MatthewMa11/WebbSubmarineROV/docs/superpowers/specs/2026-10-26-club-website.md

# Webb Submarine ROV Club Website

Date: October 26, 2026

The user authorized a public club website and a public GitHub repository. The site introduces the club, shows actual engineering work, explains its museum vision, and makes journals and CAD downloads easy to find. The root agent owns GitHub publication and browser verification.

## Approach

Use a buildless static page at the repository root for GitHub Pages. A framework would add unnecessary build and dependency maintenance to this editorial site. Sites hosting is not used because the requested host is GitHub Pages. The existing project checkout and source image paths are retained.

## Content and design

Use deep navy, warm cream, and cyan with large system typography, ruled editorial sections, and prominent authentic CAD imagery. The opening combines the club's underwater engineering purpose with the current thruster model. Subsequent sections explain current development, link both journals, introduce prospective museum education and documentation, and provide the print kit and archive.

The current configuration is R14 housing + R13 concave cone + R11 fan. Distinguish CAD/fabrication development from demonstrated underwater operation. Keep the museum unnamed and activities aspirational. Do not invent membership, achievements, partnerships, contact details, or performance specifications.

## Files and constraints

- `index.html`: semantic content and native link navigation.
- `site-assets/site.css`: all styles, responsive layouts and accessibility states.
- `.nojekyll`: serve the static source directly on GitHub Pages.
- No external dependencies, fonts, analytics, frameworks, or required JavaScript.
- Use existing CAD images through relative paths; no copied or generated assets.
- GitHub links target `MatthewMa11/WebbSubmarineROV` and the established CAD release.

## Verification

Check local asset existence, fragment targets, heading hierarchy, accessible image text, metadata, and relative image/style URLs. The parent agent verifies the actual desktop and narrow-screen rendering, keyboard focus, links, publication and HTTP response. Do not claim deployment from local checks.
