MatthewMa11/WebbSubmarineROV/cad/concave-cap-r13-2026-10-25/native-saved-version.txt

Browser tab: 5, Title: "A2212 R8 - M3 axle-clamp fan - separate design | R13 thruster - concave cone and M3x12 joints", URL: "https://cad.onshape.com/documents/743ab214882a2e3f8cf7645e/v/b026d3e43969875b68fe1d72/e/7d8ed648695214607ccb8d84".
0 AXWebArea A2212 R8 - M3 axle-clamp fan - separate design | R13 thruster - concave cone and M3x12 joints, URL: cad.onshape.com/documents/743ab214882a2e3f8cf7645e/v/b026d3e43969875b68fe1d72/e/7d8ed648695214607ccb8d84
	1 container
		2 image
		3 container
			4 link Description: The Onshape logo., Value: cad.onshape.com/documents
			5 text A2212 R8 - M3 axle-clamp fan - separate design R13 - concave cone - front M3x12 joints
			653 image
			7 button Explore Onshape
				8 image
				9 text Explore Onshape
			10 button Description: Notifications, ID: user-notification-status
				11 container
					12 image
					13 container 9+ unread notifications
						14 text 9+
			15 link Navigates you to Action items page in a new window.
			16 link Navigates you to Onshape app store in a new window.
			17 link Navigates you to Onshape Learning Center in a new window.
			654 button Share
			19 container Help menu
			20 pop up button (collapsed) Matthew Ma, Secondary Actions: Expand
				21 text Matthew Ma
		22 container model-body
			23 container
				24 image
				655 image
				27 image
				28 image
				656 image
				30 image
				31 image
				657 container
					658 container
						660 container
							661 text Versions are view only. Viewing R13 - concave cone - front M3x12 joints.
							662 button Return to R13 - concave cone and short-bolt joints
							663 link cad.onshape.com/help/index.htm#cshid=versionshistorymanager
						659 container content-div
							664 container
								665 container assembly-tree
									666 pop up button (collapsed) Secondary Actions: Expand
									667 text field (settable)
									668 button filter-flat-list-view
										669 image
									670 text Instances (47)
									671 container
										672 container
											673 image
											674 text R13 thruster - concave cone and M3x12 joints
										675 container
											676 image
											677 image
											678 text Origin
										679 container
											680 image
											681 image
											682 text R13 concave cone -24mm bowl - M3x12 joints <1>
										683 container
											684 image
											685 image
											686 text R13 one-piece housing - front captive nuts and pilots <1>
										687 container
											688 image
											689 image
											690 text R11 fan - actual adapter, 5.1 bore, 7.145 hub <1>
										691 container
											692 image
											693 image
											694 text M4 flat washer 9x4.3x0.8 - 1 <1>
										695 container
											696 image
											697 image
											698 text M4 flat washer 9x4.3x0.8 - 2 <1>
										699 container
											700 image
											701 image
											702 text M4 flat washer 9x4.3x0.8 - 3 <1>
										703 container
											704 image
											705 image
											706 text M4 flat washer 9x4.3x0.8 - 4 <1>
										707 container
											708 image
											709 image
											710 text M4 hex nut AF7x3.2 - 1 <1>
										711 container
											712 image
											713 image
											714 text M4 hex nut AF7x3.2 - 2 <1>
										715 container
											716 image
											717 image
											718 text M4 hex nut AF7x3.2 - 3 <1>
										719 container
											720 image
											721 image
											722 text M4 hex nut AF7x3.2 - 4 <1>
										723 container
											724 image
											725 image
											726 text M4x12 socket mounting bolt 1 <1>
										727 container
											728 image
											729 image
											730 text M4x12 socket mounting bolt 2 <1>
										731 container
											732 image
											733 image
											734 text M4x12 socket mounting bolt 3 <1>
										735 container
											736 image
											737 image
											738 text M4x12 socket mounting bolt 4 <1>
										739 container
											740 image
											741 image
											742 text M3 captured cover nut 1 <1>
										743 container
											744 image
											745 image
											746 text M3 captured cover nut 2 <1>
										747 container
											748 image
											749 image
											750 text M3 front washer cover 1 <1>
										751 container
											752 image
											753 image
											754 text M3 front washer cover 2 <1>
										755 container
											756 image
											757 image
											758 text M3 flat washer motor base 1 <1>
										759 container
											760 image
											761 image
											762 text M3 flat washer motor base 3 <1>
										763 container
											764 image
											765 image
											766 text R13 M3x12 cone bolt 1 <1>
										767 container
											768 image
											769 image
											770 text R13 M3x12 cone bolt 3 <1>
										771 container
											772 image
											773 image
											774 text M3x8 motor-base screw 2 <1>
										775 container
											776 image
											777 image
											778 text M3x8 motor-base screw 4 <1>
										779 container
											780 image
											781 image
											782 text M3 captured cover nut 3 <1>
										783 container
											784 image
											785 image
											786 text M3 front washer cover 3 <1>
										787 container
											788 image
											789 image
											790 text M3 flat washer motor base 2 <1>
										791 container
											792 image
											793 image
											794 text M3 flat washer motor base 4 <1>
										795 container
											796 image
											797 image
											798 text R13 M3x12 cone bolt 2 <1>
								799 image
								800 container viewerdiv
									801 image canvas
									802 container
										803 button
											804 image
										805 button
											806 image
										807 button
											808 image
								809 container
									810 image
									811 image
									812 image
									813 image
									814 image
									815 image
						816 container os-tab-bar
							817 container
								818 container
									819 image
									820 text Part Studio 1
								821 container
									822 image
									823 text Thruster print fit
								824 container
									825 image
									826 text Thruster-A2212-fit-check.step
								827 container
									828 image
									829 text R13 thruster - concave cone and M3x12 joints
								830 container
									831 image
									832 text R11-actual-Motor-source-stage
								833 container
									834 image
									835 text Nozzle R5 - verified manifold print mesh
								836 container
									837 image
									838 text Nozzle R5 - verified manifold print mesh.stl
								839 container
									840 image
									841 text R13 parts - concave cone and short-bolt joints
								842 container
									843 image
									844 text R11 native Motor source - linked originals
								845 container
									846 image
									847 text Assembly 1
								848 container
									849 image
									850 text CAD Imports

The focused UI element is 0 AXWebArea A2212 R8 - M3 axle-clamp fan - separate design | R13 thruster - concave cone and M3x12 joints, URL: cad.onshape.com/documents/743ab214882a2e3f8cf7645e/v/b026d3e43969875b68fe1d72/e/7d8ed648695214607ccb8d84
