MatthewMa11/WebbSubmarineROV/cad/metal-collet-r10-2026-10-25/native-version.txt

Saved version: cc9d5f72788640984612fdc3
https://cad.onshape.com/documents/743ab214882a2e3f8cf7645e/v/cc9d5f72788640984612fdc3/e/7d8ed648695214607ccb8d84
Editable R10 workspace:
https://cad.onshape.com/documents/743ab214882a2e3f8cf7645e/w/19f580305ee8d4219aed16cb/e/7d8ed648695214607ccb8d84
