MatthewMa11/WebbSubmarineROV/cad/shaft-clamp-r8-2026-10-25/progress.md

# R8 separate document - plan: PLAN.txt

Pre-flight: source Feature Studio copied into the new document with its native assembly dependencies. Original R7 document remains untouched.
Task 1 complete: new document 743ab214882a2e3f8cf7645e, workspace bc0473dfaa69abe9537b29fe, copied Feature Studio 16c25ac6dc3eebc1370b77e9.
Task 2 RED: audit_r8.py on native R7 STEP fails missing jaw, wrong body count, rings retained, no axle gripping material; expected failures recorded in baseline-red.json.
Ruling: preserve four motor drive keys to carry torque while a 3.05 mm axle grip supplies retention. Cap begins Y20, so longer grip would violate the preserved cap placement. Cost: physical retention cannot be certified from this short printed grip.
Ruling: use two M3x16 bolts without washers at the new shaft clamp. Broad printed bearing faces fit beneath the unchanged cap; opposed hardware directions maintain mass symmetry. Cost: PLA bearing creep must be checked physically.
Task 2 complete: copied local FS regenerates47 PS parts including unusedmesh; native assembly46, Group2seven. Initial native STEP independent requirements all pass. Main frame/cap/rotor/stator and36stationaryfasteners unchanged. NewSTLs pluscoupon eachclosedmanifold. Native fullturn360 andNo interferences captured.
Final review Important: nutdriver access fails on initial6.8 mm wells (36..38 mm3 intersection at each8.4 mm OD tool corridor). Fix: widen wells to8.6 mm outside bearing faces; keep seats, bores and fasteners unchanged. verify_tool_access.py records RED before sourcefix.
Final: fixed nutdriver obstruction, RED->GREEN four8.4 mm corridors allzero overlap after native regeneration and fresh assemblySTEP export. Final fullverify_r8, closure/coupon/mesh checks and nativeNoInterferences pass. No additional actionable minors.
Final: physical force, pull-off, key strength, fatigue, tightening torque, PLA life, speed and balance remain test requirements; no geometry-only certification. See FINAL-REVIEW.txt ruling and saved versiondescription for the failure costs.
Task 3 complete: separate native assembly46parts, Group2seven, no oldringinstances or obsoleteR7explodedview; originaldocument notedited. Saved R8version08ca331c2c6a742a5f519f05; fullframe/cap shown, newtabmarked deliverable.
Task 4 complete: final nativeSTEP fullsuite passes; geometricclosure, couponB-rep, all3newnativeSTLs and printorientedSTLs pass. Allfour8.4 mm toolcorridors clear. NativeSTLvolume match errors0.03853%fan and0.005144%jaw; ZIP14,620,305bytes before appendedartifactreport, CRC and everyfile checked. PRINT includes fan,jaw,coupon plus unchangedframe/cap. ASSEMBLY-AND-PRINT.txt and finalreview included. No further implementation or verification work remains; physical validation explicitly outstanding for user.
