MatthewMa11/WebbSubmarineROV/cad/sketch-layout-r9-2026-10-25/progress.md

# R9 ledger - plan: PLAN.md

FINAL ACTIVE VALUES:8.0 mm forward translation, R20 flatdiskY12.8..19.3,
all root tools boundedR26.9, original outerprofile retained beyondR27.01,
bench-first clamping and continuous front insertion. Earlier trial values
below are superseded development history, not the delivered design.

Spec: user sketch selects cap--fan--motor--rear-support layout and explicitly requests execution. Preserve existing frame/cap and prior M3 axle-clamp constraints. No new mechanism selection is needed.
Pre-flight: move blades before creating clamp ears so the rear-cup removal cannot open the bolt holes. Preserve native original fan body identity for assembly mates. R8 source/helper is reused, not modified.
Ruling: implement within unchanged stationary geometry by moving blades8.2 mm forward and flattening the hub, rather than lengthening the frame/cap. Cost: shaft grip remains3.05 mm and requires physical retention validation.
Native isolation: R9 workspace f840c75829657ff4af820013 branched from saved R8version08ca331c2c6a742a5f519f05 in the existing separate document.
Task1 RED: layout_test on nativeR8 failed both rear-cup removal and blade-forward placement as expected. Native initial rebuild found INTERSECTION consumes the copied body's identity/tag; diagnostic showed tagged bodies0, copyquery0, bandresult1. Reattach stage tag to the actual native intersectionresult before further subtraction; keep all connectivity guards.
Native root-join guard then found no intersection edges. Independent R8STEP surface inspection confirms original hubR18, notR20. Add a new rounded flatR20disk overlapping R19bladeroots by1 mm, and check union of allfan/blade identities for one body; no connectivity guard removed.
Root blend RED: newRootRounds0.35 fails where the pre-rounded disk rim overlaps the blade junction. Give the root0.45 mm axial shoulder at both ends (outer rear rimY13.9, frontY19.3), blend roots before small perimeter rounds, then apply existing R8motor-envelope relief. Front coplanarity also gives a broad print-bed face. No frame/cap dimension changes.
Rootrounds now succeed. Perimeter guard corrected from exactly2topologicaledges to both R20 physical perimeters (atY13.9 and19.3); native Boolean splits a circle into multiple arcs. Radius/plane filters and both-end coverage remain mandatory.
First native47part rebuild and46bodyassembly pass all clamp/key/clearance tests, but independent outerblade comparison fails: original outerblade746.1984 mm3 vs clipped700.1782, and new700.1638. The initial narrow axial crop removes46.0202 mm3 and a broad edge query rounds some free edges (0.01435 mm3 difference). Fix by preserving full outerprofile inY5.3..11.4, tapering only inner root fronts and limiting blend edges toR20 junctions on both blades. Move8.7 mm forward so full outerblade bounds lie ahead ofY14; use a stepped radial sweep to check the longer pitched blade fronts against cap. Test band bounds changed to this updated physical design, not relaxed to hide interference.
Ruling: use a stepped radial full-turn envelope instead of a full-diameter cylinder to the blade's frontmostY20.1. The narrow hub endsY19.3; the farther-forward blade material lies outside the cap's center. Cost if wrong: cap interference; require zero escaped volume and direct envelope-distance checks.
Further verification RED:8.7 mm design still loses2.6758 mm3 of outerprofile from broad axial clipping, and stepped envelope has only0.3933 mm cap margin. Preserve the complete original blades without an axial band; bound every root-cut tool insideR26.9 and move8.0 mm forward, leaving more cap allowance. The blade-plane test uses axial centroid ahead ofY15 plus separate direct motor-interference checks, rather than assuming all points of a pitched blade lie beyond the motor face. Rootjunctions remain explicitly R20 only; stepped envelope nowendsY19.61 outsideR21.93.
Task1 complete: final47PSparts/native46assemblybodies, onevalidflatfanbody and allguards pass. OriginalR8workspace/version remains intact.
Task2 complete: final fresh verify_r9.py exits0; all20geometric checks pass. NativeNoInterferences and completed360degreeanimation captured. Both newprintparts+coupon closedmanifold; entirefanBRepvalid. Allstationarygeometry/poses unchanged.
Final review: twoImportant findings, noCritical. Fixed driveraccess by bench-first preassembly; in-frame70 mm tool RED, bench70 mm + continuous8component insertion corridor GREEN. Fixed unreliable outerprofile metric with densevalidSTL surfaces: negativecontrol7 mm vs8 mm shift RED (~1.006mm), correct8 mm GREEN (max0.016965mm,107278samples). Main suite rerun exits0. SeeFINAL-REVIEW.txt for active rulings and physical-test limits. No remaining actionable review issues.
Saved nativeR9version22f92fdd7289c8541ee5c673; finalside and complete screenshots refreshed after STEP export. Package/artifact validation is the remaining task.

Task3 complete: savedR9version22f92fdd7289c8541ee5c673, native360completion and refreshedside/completeviews, PRINT5files singleclosednewmeshes, ZIP17entries+artifactreport. Finalartifactcheck exits0: fan/nativevolumeerror0.02870%, jaw0.005144%, CRC and everyZIPentrymatch. AllreviewImportantissuesfixed, no furtherCAD/exportwork remains. Physical fit/load validation is userwork and is explicitly required in allinstructions.
