MatthewMa11/WebbSubmarineROV/cad/smooth-frame-r14-2026-10-25/progress.md

# R14 ledger
User specifies smoother frame and removal of pictured old crescent feature.
Inspection: four obsolete R5 old flanges Y13..18 with nut/washer slots, separate
from current short-bolt joints Y40.5..55.5. No current hardware uses them.
Ruling: remove all four symmetrically, fair the main exterior transition and
shorten unused post tails to rounded roots; retain working R13 interfaces.
Cost if wrong: new frame print; compare all functional interfaces and clearances.
Native version R13 retained as baseline; implementation isolated in new branch.
New workspace190d11a3b29f4ed46f4284fa. Cleanup RED againstR13 observed3failures:
old crescent probe occupancy, fairing profile and rounded post roots. All5
cleanup checks GREEN onR14; interface21/21 GREEN. Insertion and all4nut/washer
loading sweeps GREEN. Native scoped cone/frame/fan check No interferences.
Actual native47-part assembly shape signatures and poses match verified studio.
Fine frame STL511952triangles, closed manifold,1component, no discarded bits;
native volume125083.529mm3, STLrelative error0.02334%. Reused cone and fan file
hashes match prior versions. Print surfaces outside altered zones pass0.02mm.
Fresh review: no Critical/Important findings. Deferred minor: other46body
checks compare geometric signatures rather than full topological identity.
Ruling: curvature-continuous outer fairing and0.6mm post-root fillets used as
the requested smoothing; P1S0.12mm layers recommended for actual print finish.
Cost if real finish differs: layer/support tuning, not an assurance of polish.
Saved version8bf42d2b29fd6d1247b16a59; verify browser capture before package.
Task1 andTask2 complete. Saved version view-only47instances captured; final
24-entry ZIP gate GREEN with CRC and contents matching verified sources.
R14-Smooth-Frame-Print-Kit.zip13526821bytes, six printable STLs.
