MatthewMa11/WebbSubmarineROV/site-assets/vision/CREDITS.md

# Vision journal visual sources

- `pivot-rov-example.jpg`: User-supplied reference image, received October 27, 2026 as `pivot-rov-underwater-drone-1.webp`. Converted to JPEG for the journal builder; composition and dimensions preserved. Original photographer and license were not supplied. Depicts an example vehicle, not the club’s ROV.
- `chasing-m2-rov-example.jpg`: User-supplied reference image, received October 27, 2026 as `codex-clipboard-96e81ced-ffa3-4cf7-934d-b9e3d48cfbfb.png`. Vehicle label reads CHASING M2. Converted to JPEG for the journal builder; composition and dimensions preserved. Original creator and license were not supplied. Depicts an example vehicle, not the club’s ROV.
- `noaa-little-hercules.jpg`: NOAA Okeanos Explorer Program, Mid-Cayman Rise Expedition 2011. Little Hercules viewed from Seirios, August 5, 2011. Public domain. Source: https://commons.wikimedia.org/wiki/File:Expl275272745x800x800.jpg . Original: https://upload.wikimedia.org/wikipedia/commons/3/38/Expl275272745x800x800.jpg . Used without modification.
- `rov-jason-launch.jpg`: University of Washington, V19. Jason launching from R/V Atlantis during the 2019 Regional Cabled Array maintenance cruise. Image from work supported by the U.S. National Science Foundation Ocean Observatories Initiative. Public use with acknowledgement: https://oceanobservatories.org/image-gallery/ . Metadata: https://commons.wikimedia.org/wiki/File:ROV_Jason_launch_(OOI_230).jpg . Original: https://oceanobservatories.org/wp-content/gallery/2020-image-gallery/J1147_20190614_060607_launch.jpg . Used without modification.
- `noaa-deep-discoverer.jpg`: NOAA, August 1, 2014. Public domain per https://www.fws.gov/media/rov-deep-discoverer . Original: https://www.fws.gov/sites/default/files/images/2024-03/rov_deep_discoverer.jpg
- `noaa-control-room.jpg`: Image courtesy of NOAA Ocean Exploration, 2022 ROV and Mapping Shakedown. Source: https://oceanexplorer.noaa.gov/multimedia/okeanos-explorations-ex2201-gallery-media-control-room/ . Image: https://oceanexplorer.noaa.gov/wp-content/uploads/2022/05/control-room-hires-1024x610.jpg
- The three SVG graphics are original explanatory illustrations for this journal. Their PNG exports are used by the existing journal builder. Frame counts come from `cad/easy-assembly-2026-10-18/READ-ME.txt`. The museum display graphic was removed from the journal on October 27, 2026. The roadmap was updated the same day to show the club’s Thanksgiving build target, first water trial, and goal of diving at least 20 meters before summer break, by the end of the 2026–27 school year. These milestones are goals, not completed tests or a verified depth rating.
- The three project CAD images remain in their original `cad/` locations and are identified by revision in the journal captions.
