MatthewMa11/WebbSubmarineROV/archives/README.md

# CAD archive downloads

The [CAD development release](https://github.com/MatthewMa11/WebbSubmarineROV/releases/tag/cad-archive-2026-10-26) hosts these downloads. These archives preserve the original dated CAD folders, source files, geometry, pictures, reports, and original print packages. Each ZIP is independently extractable. To restore a revision completely, download **all** ZIPs listed for it and extract them into the same project root; the archives already contain the original `cad/<revision>/` paths. No split-file joining utility is required.

For the current thruster print parts, use the separate [R14 print kit](R14-Smooth-Frame-Print-Kit.zip) and [assembly guide](../cad/smooth-frame-r14-2026-10-25/ASSEMBLY-AND-PRINT.txt). The full archives also preserve earlier versions and diagnostic exports.

| Revision folder | Download | Original files | Size |
|---|---|---:|---:|
| `actual-onshape-motor-r11-2026-10-25` | [actual-onshape-motor-r11-2026-10-25-archive-01.zip](https://github.com/MatthewMa11/WebbSubmarineROV/releases/download/cad-archive-2026-10-26/actual-onshape-motor-r11-2026-10-25-archive-01.zip) | 38 | 17.89 MiB |
| `actual-onshape-motor-r11-2026-10-25` | [actual-onshape-motor-r11-2026-10-25-archive-02.zip](https://github.com/MatthewMa11/WebbSubmarineROV/releases/download/cad-archive-2026-10-26/actual-onshape-motor-r11-2026-10-25-archive-02.zip) | 20 | 14.71 MiB |
| `bolt-free-retention-2026-10-24` | [bolt-free-retention-2026-10-24-archive-01.zip](https://github.com/MatthewMa11/WebbSubmarineROV/releases/download/cad-archive-2026-10-26/bolt-free-retention-2026-10-24-archive-01.zip) | 16 | 19.86 MiB |
| `bolt-free-retention-2026-10-24` | [bolt-free-retention-2026-10-24-archive-02.zip](https://github.com/MatthewMa11/WebbSubmarineROV/releases/download/cad-archive-2026-10-26/bolt-free-retention-2026-10-24-archive-02.zip) | 16 | 14.27 MiB |
| `bolt-free-retention-2026-10-24` | [bolt-free-retention-2026-10-24-archive-03.zip](https://github.com/MatthewMa11/WebbSubmarineROV/releases/download/cad-archive-2026-10-26/bolt-free-retention-2026-10-24-archive-03.zip) | 33 | 16.07 MiB |
| `concave-cap-r13-2026-10-25` | [concave-cap-r13-2026-10-25-archive-01.zip](https://github.com/MatthewMa11/WebbSubmarineROV/releases/download/cad-archive-2026-10-26/concave-cap-r13-2026-10-25-archive-01.zip) | 31 | 15.82 MiB |
| `concave-cap-r13-2026-10-25` | [concave-cap-r13-2026-10-25-archive-02.zip](https://github.com/MatthewMa11/WebbSubmarineROV/releases/download/cad-archive-2026-10-26/concave-cap-r13-2026-10-25-archive-02.zip) | 8 | 11.73 MiB |
| `concave-cap-r13-2026-10-25` | [concave-cap-r13-2026-10-25-archive-03.zip](https://github.com/MatthewMa11/WebbSubmarineROV/releases/download/cad-archive-2026-10-26/concave-cap-r13-2026-10-25-archive-03.zip) | 8 | 13.81 MiB |
| `cover-through-bolts-2026-10-17` | [cover-through-bolts-2026-10-17-archive-01.zip](https://github.com/MatthewMa11/WebbSubmarineROV/releases/download/cad-archive-2026-10-26/cover-through-bolts-2026-10-17-archive-01.zip) | 14 | 14.60 MiB |
| `cover-through-bolts-2026-10-17` | [cover-through-bolts-2026-10-17-archive-02.zip](https://github.com/MatthewMa11/WebbSubmarineROV/releases/download/cad-archive-2026-10-26/cover-through-bolts-2026-10-17-archive-02.zip) | 3 | 10.39 MiB |
| `cover-through-bolts-2026-10-17` | [cover-through-bolts-2026-10-17-archive-03.zip](https://github.com/MatthewMa11/WebbSubmarineROV/releases/download/cad-archive-2026-10-26/cover-through-bolts-2026-10-17-archive-03.zip) | 4 | 12.52 MiB |
| `cover-through-bolts-2026-10-17` | [cover-through-bolts-2026-10-17-archive-04.zip](https://github.com/MatthewMa11/WebbSubmarineROV/releases/download/cad-archive-2026-10-26/cover-through-bolts-2026-10-17-archive-04.zip) | 14 | 13.61 MiB |
| `easy-assembly-2026-10-18` | [easy-assembly-2026-10-18-archive-01.zip](https://github.com/MatthewMa11/WebbSubmarineROV/releases/download/cad-archive-2026-10-26/easy-assembly-2026-10-18-archive-01.zip) | 137 | 3.46 MiB |
| `eight-thruster-assembly-2026-10-17` | [eight-thruster-assembly-2026-10-17-archive-01.zip](https://github.com/MatthewMa11/WebbSubmarineROV/releases/download/cad-archive-2026-10-26/eight-thruster-assembly-2026-10-17-archive-01.zip) | 52 | 6.93 MiB |
| `flatter-motor-boss-2026-10-24` | [flatter-motor-boss-2026-10-24-archive-01.zip](https://github.com/MatthewMa11/WebbSubmarineROV/releases/download/cad-archive-2026-10-26/flatter-motor-boss-2026-10-24-archive-01.zip) | 9 | 14.20 MiB |
| `flatter-motor-boss-2026-10-24` | [flatter-motor-boss-2026-10-24-archive-02.zip](https://github.com/MatthewMa11/WebbSubmarineROV/releases/download/cad-archive-2026-10-26/flatter-motor-boss-2026-10-24-archive-02.zip) | 7 | 13.13 MiB |
| `laser-frame-electronics-2026-10-17` | [laser-frame-electronics-2026-10-17-archive-01.zip](https://github.com/MatthewMa11/WebbSubmarineROV/releases/download/cad-archive-2026-10-26/laser-frame-electronics-2026-10-17-archive-01.zip) | 229 | 5.63 MiB |
| `metal-collet-r10-2026-10-25` | [metal-collet-r10-2026-10-25-archive-01.zip](https://github.com/MatthewMa11/WebbSubmarineROV/releases/download/cad-archive-2026-10-26/metal-collet-r10-2026-10-25-archive-01.zip) | 28 | 11.92 MiB |
| `metal-collet-r10-2026-10-25` | [metal-collet-r10-2026-10-25-archive-02.zip](https://github.com/MatthewMa11/WebbSubmarineROV/releases/download/cad-archive-2026-10-26/metal-collet-r10-2026-10-25-archive-02.zip) | 9 | 8.86 MiB |
| `metal-collet-r10-2026-10-25` | [metal-collet-r10-2026-10-25-archive-03.zip](https://github.com/MatthewMa11/WebbSubmarineROV/releases/download/cad-archive-2026-10-26/metal-collet-r10-2026-10-25-archive-03.zip) | 7 | 12.68 MiB |
| `motor-centering-cover-2026-10-17` | [motor-centering-cover-2026-10-17-archive-01.zip](https://github.com/MatthewMa11/WebbSubmarineROV/releases/download/cad-archive-2026-10-26/motor-centering-cover-2026-10-17-archive-01.zip) | 15 | 11.56 MiB |
| `motor-centering-cover-2026-10-17` | [motor-centering-cover-2026-10-17-archive-02.zip](https://github.com/MatthewMa11/WebbSubmarineROV/releases/download/cad-archive-2026-10-26/motor-centering-cover-2026-10-17-archive-02.zip) | 5 | 18.25 MiB |
| `motor-centering-cover-2026-10-17` | [motor-centering-cover-2026-10-17-archive-03.zip](https://github.com/MatthewMa11/WebbSubmarineROV/releases/download/cad-archive-2026-10-26/motor-centering-cover-2026-10-17-archive-03.zip) | 7 | 3.50 MiB |
| `one-piece-housing-r12-2026-10-25` | [one-piece-housing-r12-2026-10-25-archive-01.zip](https://github.com/MatthewMa11/WebbSubmarineROV/releases/download/cad-archive-2026-10-26/one-piece-housing-r12-2026-10-25-archive-01.zip) | 20 | 19.99 MiB |
| `one-piece-housing-r12-2026-10-25` | [one-piece-housing-r12-2026-10-25-archive-02.zip](https://github.com/MatthewMa11/WebbSubmarineROV/releases/download/cad-archive-2026-10-26/one-piece-housing-r12-2026-10-25-archive-02.zip) | 14 | 13.58 MiB |
| `one-piece-housing-r12-2026-10-25` | [one-piece-housing-r12-2026-10-25-archive-03.zip](https://github.com/MatthewMa11/WebbSubmarineROV/releases/download/cad-archive-2026-10-26/one-piece-housing-r12-2026-10-25-archive-03.zip) | 6 | 12.69 MiB |
| `print-revision-2026-10-17` | [print-revision-2026-10-17-archive-01.zip](https://github.com/MatthewMa11/WebbSubmarineROV/releases/download/cad-archive-2026-10-26/print-revision-2026-10-17-archive-01.zip) | 1 | 10.72 MiB |
| `print-revision-2026-10-17` | [print-revision-2026-10-17-archive-02.zip](https://github.com/MatthewMa11/WebbSubmarineROV/releases/download/cad-archive-2026-10-26/print-revision-2026-10-17-archive-02.zip) | 18 | 19.93 MiB |
| `print-revision-2026-10-17` | [print-revision-2026-10-17-archive-03.zip](https://github.com/MatthewMa11/WebbSubmarineROV/releases/download/cad-archive-2026-10-26/print-revision-2026-10-17-archive-03.zip) | 16 | 12.05 MiB |
| `remove-wire-holder-2026-10-21` | [remove-wire-holder-2026-10-21-archive-01.zip](https://github.com/MatthewMa11/WebbSubmarineROV/releases/download/cad-archive-2026-10-26/remove-wire-holder-2026-10-21-archive-01.zip) | 11 | 9.44 MiB |
| `shaft-clamp-r8-2026-10-25` | [shaft-clamp-r8-2026-10-25-archive-01.zip](https://github.com/MatthewMa11/WebbSubmarineROV/releases/download/cad-archive-2026-10-26/shaft-clamp-r8-2026-10-25-archive-01.zip) | 26 | 15.04 MiB |
| `shaft-clamp-r8-2026-10-25` | [shaft-clamp-r8-2026-10-25-archive-02.zip](https://github.com/MatthewMa11/WebbSubmarineROV/releases/download/cad-archive-2026-10-26/shaft-clamp-r8-2026-10-25-archive-02.zip) | 11 | 14.43 MiB |
| `sketch-layout-r9-2026-10-25` | [sketch-layout-r9-2026-10-25-archive-01.zip](https://github.com/MatthewMa11/WebbSubmarineROV/releases/download/cad-archive-2026-10-26/sketch-layout-r9-2026-10-25-archive-01.zip) | 34 | 13.72 MiB |
| `sketch-layout-r9-2026-10-25` | [sketch-layout-r9-2026-10-25-archive-02.zip](https://github.com/MatthewMa11/WebbSubmarineROV/releases/download/cad-archive-2026-10-26/sketch-layout-r9-2026-10-25-archive-02.zip) | 12 | 13.26 MiB |
| `smooth-frame-r14-2026-10-25` | [smooth-frame-r14-2026-10-25-archive-01.zip](https://github.com/MatthewMa11/WebbSubmarineROV/releases/download/cad-archive-2026-10-26/smooth-frame-r14-2026-10-25-archive-01.zip) | 27 | 14.15 MiB |
| `smooth-frame-r14-2026-10-25` | [smooth-frame-r14-2026-10-25-archive-02.zip](https://github.com/MatthewMa11/WebbSubmarineROV/releases/download/cad-archive-2026-10-26/smooth-frame-r14-2026-10-25-archive-02.zip) | 10 | 10.23 MiB |
| `smooth-frame-r14-2026-10-25` | [smooth-frame-r14-2026-10-25-archive-03.zip](https://github.com/MatthewMa11/WebbSubmarineROV/releases/download/cad-archive-2026-10-26/smooth-frame-r14-2026-10-25-archive-03.zip) | 7 | 12.11 MiB |
| `spacer-free-design-2026-10-23` | [spacer-free-design-2026-10-23-archive-01.zip](https://github.com/MatthewMa11/WebbSubmarineROV/releases/download/cad-archive-2026-10-26/spacer-free-design-2026-10-23-archive-01.zip) | 19 | 14.47 MiB |
| `spacer-free-design-2026-10-23` | [spacer-free-design-2026-10-23-archive-02.zip](https://github.com/MatthewMa11/WebbSubmarineROV/releases/download/cad-archive-2026-10-26/spacer-free-design-2026-10-23-archive-02.zip) | 8 | 13.26 MiB |
| `thruster-final-optimization` | [thruster-final-optimization-archive-01.zip](https://github.com/MatthewMa11/WebbSubmarineROV/releases/download/cad-archive-2026-10-26/thruster-final-optimization-archive-01.zip) | 3 | 14.03 MiB |
| `thruster-final-optimization` | [thruster-final-optimization-archive-02.zip](https://github.com/MatthewMa11/WebbSubmarineROV/releases/download/cad-archive-2026-10-26/thruster-final-optimization-archive-02.zip) | 5 | 19.90 MiB |
| `thruster-final-optimization` | [thruster-final-optimization-archive-03.zip](https://github.com/MatthewMa11/WebbSubmarineROV/releases/download/cad-archive-2026-10-26/thruster-final-optimization-archive-03.zip) | 15 | 15.01 MiB |
| `thruster-final-optimization` | [thruster-final-optimization-archive-04.zip](https://github.com/MatthewMa11/WebbSubmarineROV/releases/download/cad-archive-2026-10-26/thruster-final-optimization-archive-04.zip) | 5 | 11.26 MiB |
| `thruster-final-optimization` | [thruster-final-optimization-archive-05.zip](https://github.com/MatthewMa11/WebbSubmarineROV/releases/download/cad-archive-2026-10-26/thruster-final-optimization-archive-05.zip) | 22 | 13.78 MiB |

## Integrity and scope

[file-inventory.csv](file-inventory.csv) lists the original relative path, byte length, SHA-256, and containing archive for each CAD file. [archive-manifest.json](archive-manifest.json) lists ZIP sizes and SHA-256 values. All archive entries passed ZIP CRC checks during packaging.

All project revision folders are retained, including the old R4 native export package with two historical meshes absent from the loose-file collection. Local executable tools, Python caches, the unrelated NVIDIA folder, temporary meeting assets, and the repository invitation screenshot are not project deliverables and are excluded.

Browse the original text sources and selected CAD previews in [cad/](../cad/), and read the [motor and fan journal](../docs/journals/motor-and-fan-cad-development.md) for the history and current status. The archives include the full image collection.
