MatthewMa11/WebbSubmarineROV/cad/actual-onshape-motor-r11-2026-10-25/native-interference.png

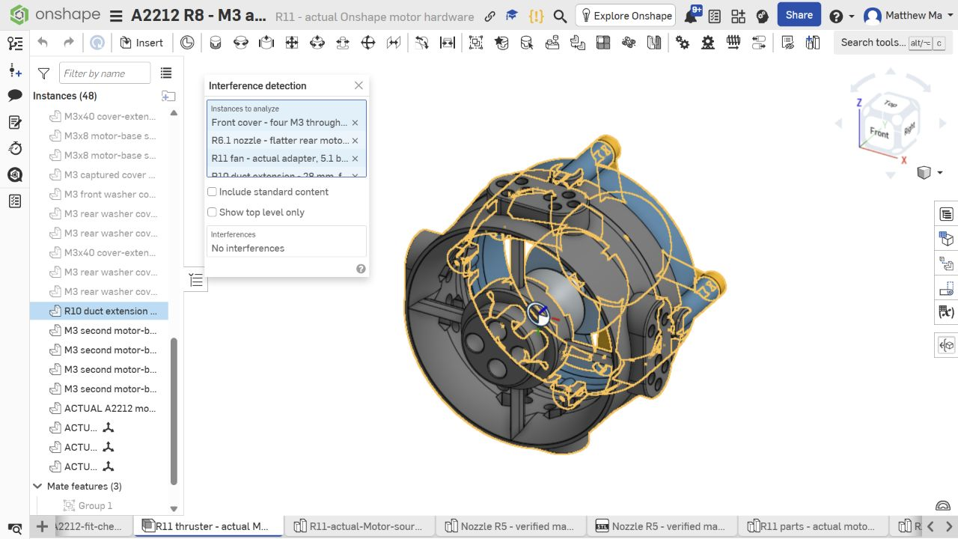
cad/actual-onshape-motor-r11-2026-10-25/native-interference.png
