MatthewMa11/WebbSubmarineROV/cad/bolt-free-retention-2026-10-24/native-360-motion.png

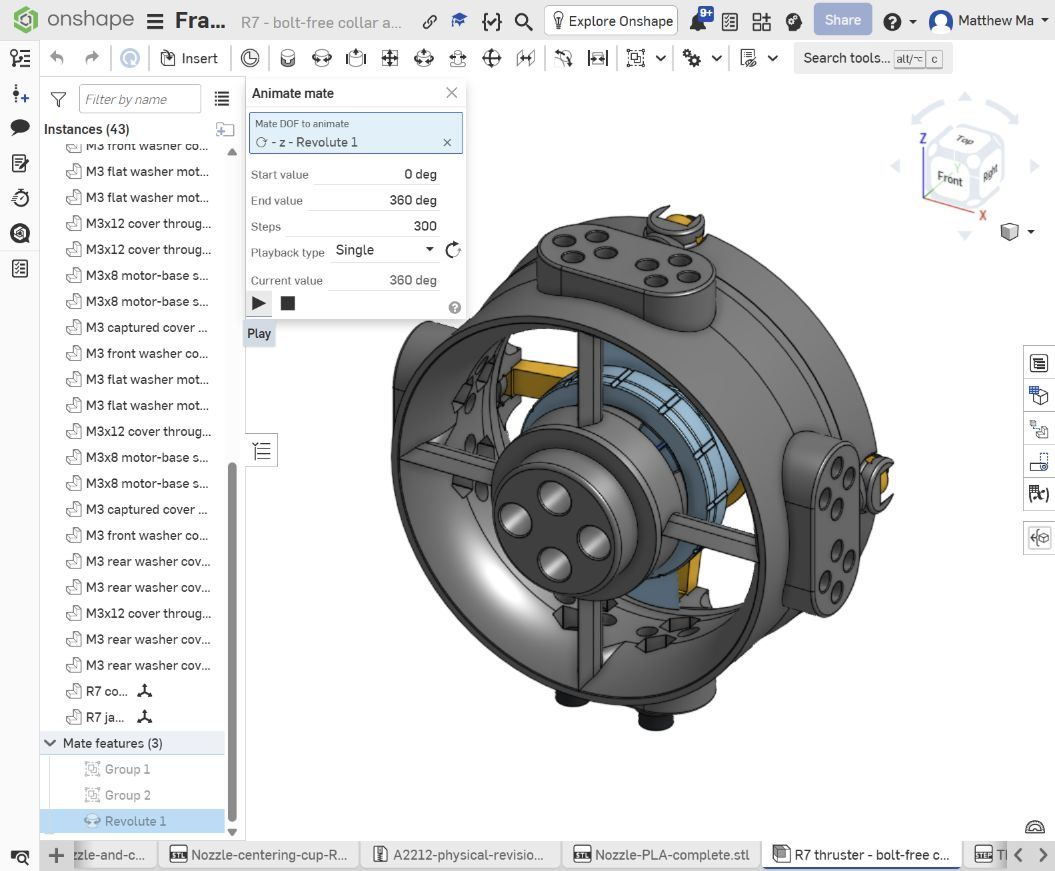
cad/bolt-free-retention-2026-10-24/native-360-motion.png
