MatthewMa11/WebbSubmarineROV/cad/bolt-free-retention-2026-10-24/native-interference-final.png

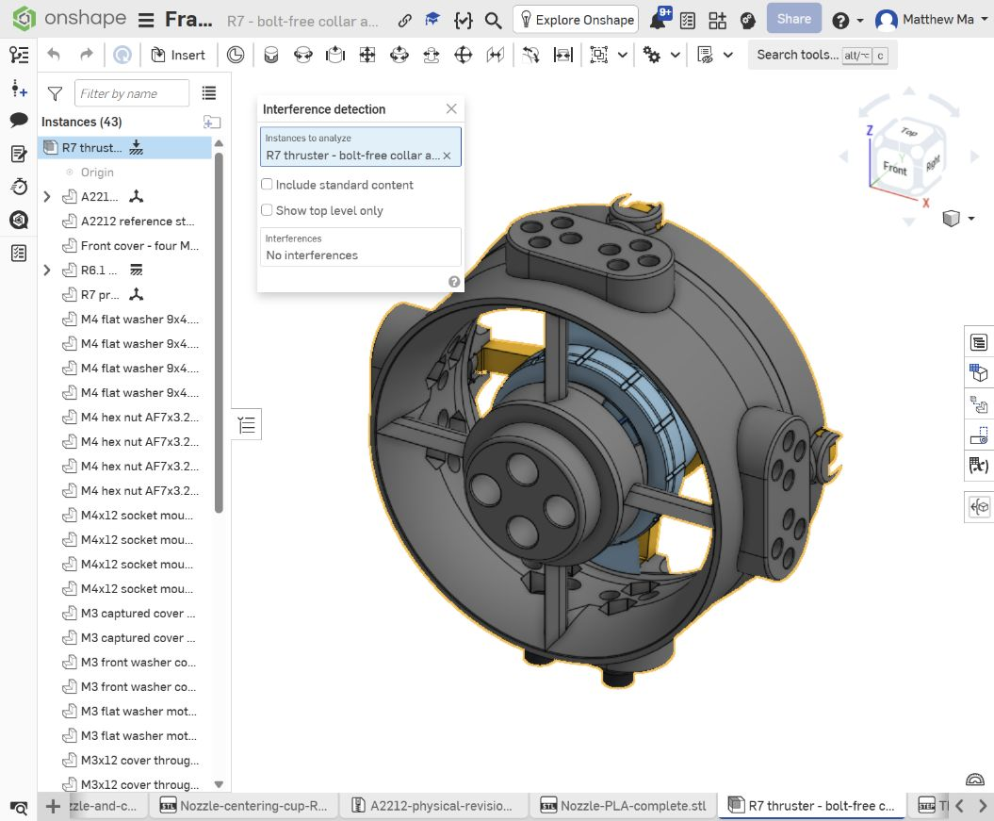
cad/bolt-free-retention-2026-10-24/native-interference-final.png
