MatthewMa11/WebbSubmarineROV/cad/bolt-free-retention-2026-10-24/R7-saved-version.png

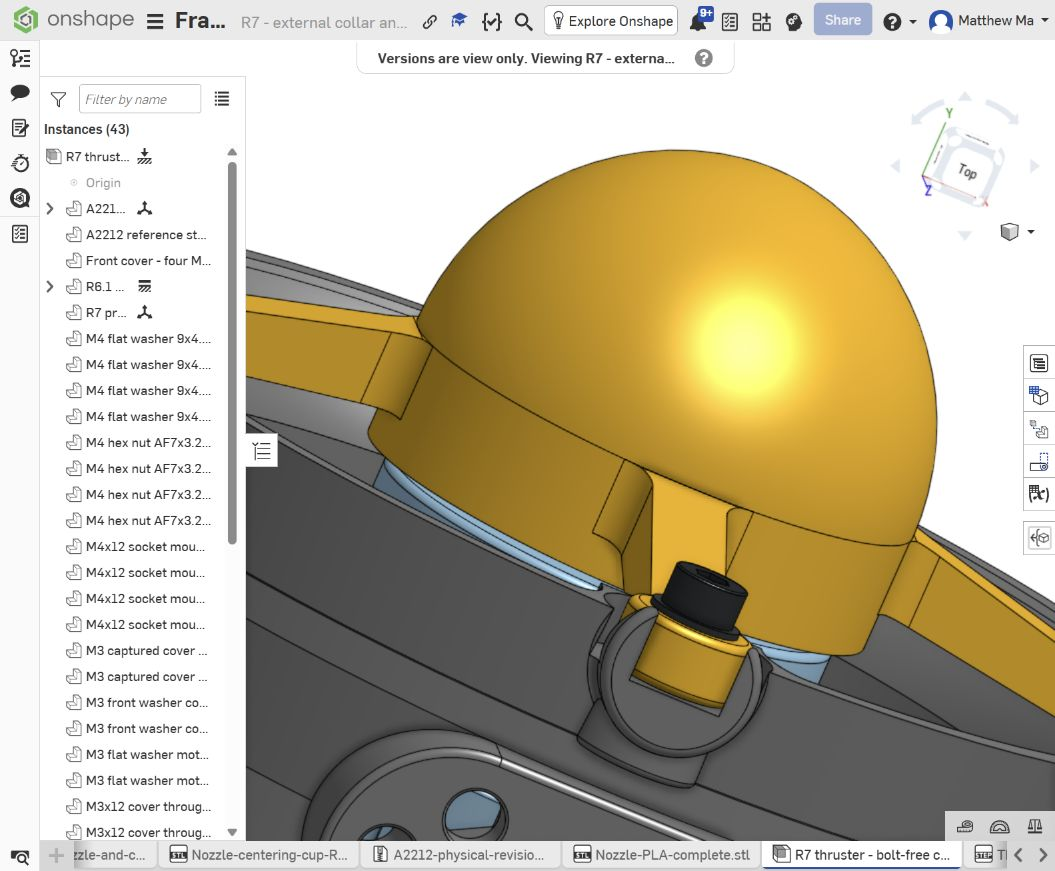
cad/bolt-free-retention-2026-10-24/R7-saved-version.png
