MatthewMa11/WebbSubmarineROV/cad/concave-cap-r13-2026-10-25/native-interference.png

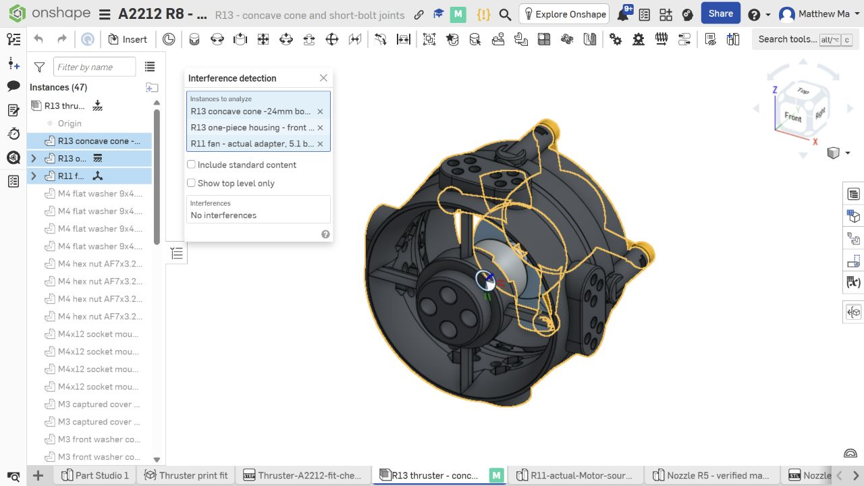
cad/concave-cap-r13-2026-10-25/native-interference.png
