MatthewMa11/WebbSubmarineROV/cad/cover-through-bolts-2026-10-17/native-interference.jpg

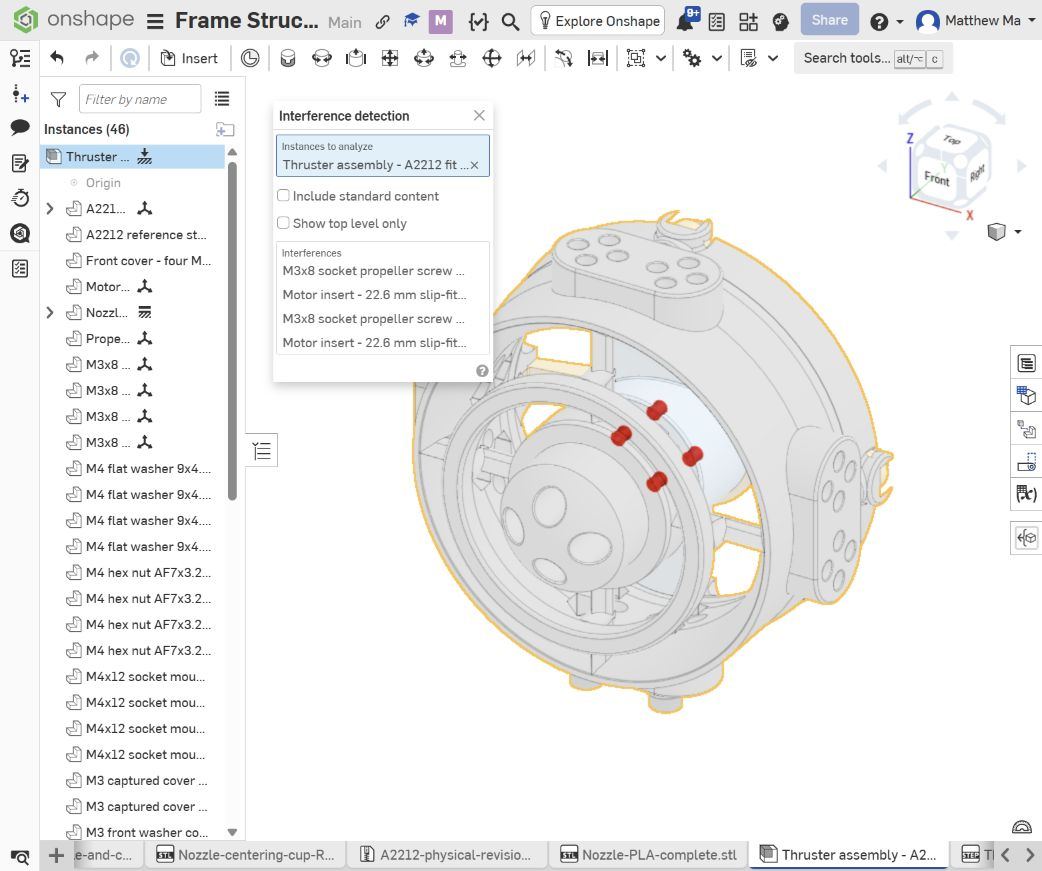
cad/cover-through-bolts-2026-10-17/native-interference.jpg
