MatthewMa11/WebbSubmarineROV/cad/laser-frame-electronics-2026-10-17/frame-and-cylinder-preview.png

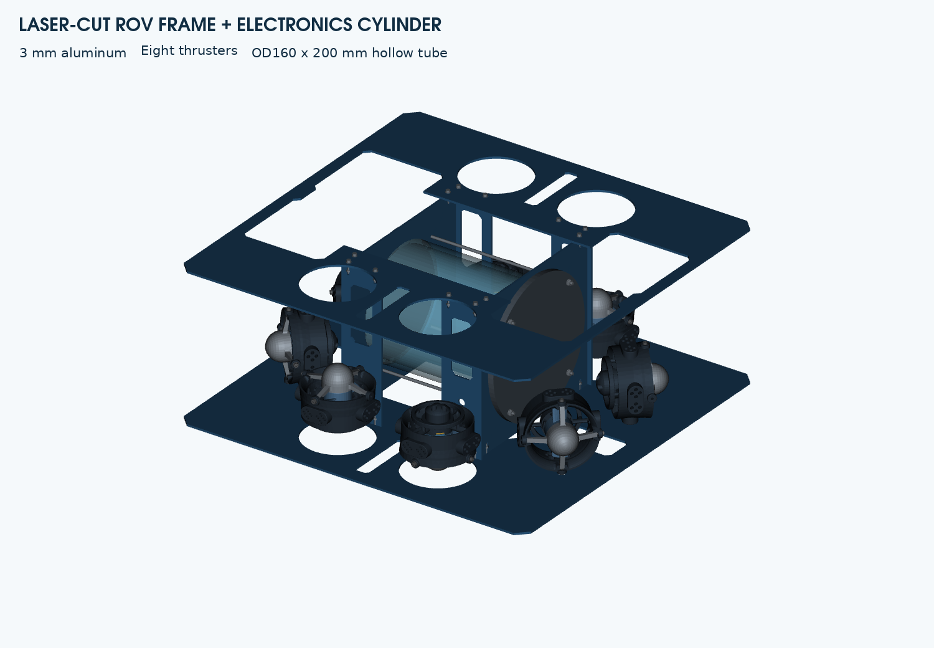
cad/laser-frame-electronics-2026-10-17/frame-and-cylinder-preview.png
