MatthewMa11/WebbSubmarineROV/rov_chassis_onshape.jpg

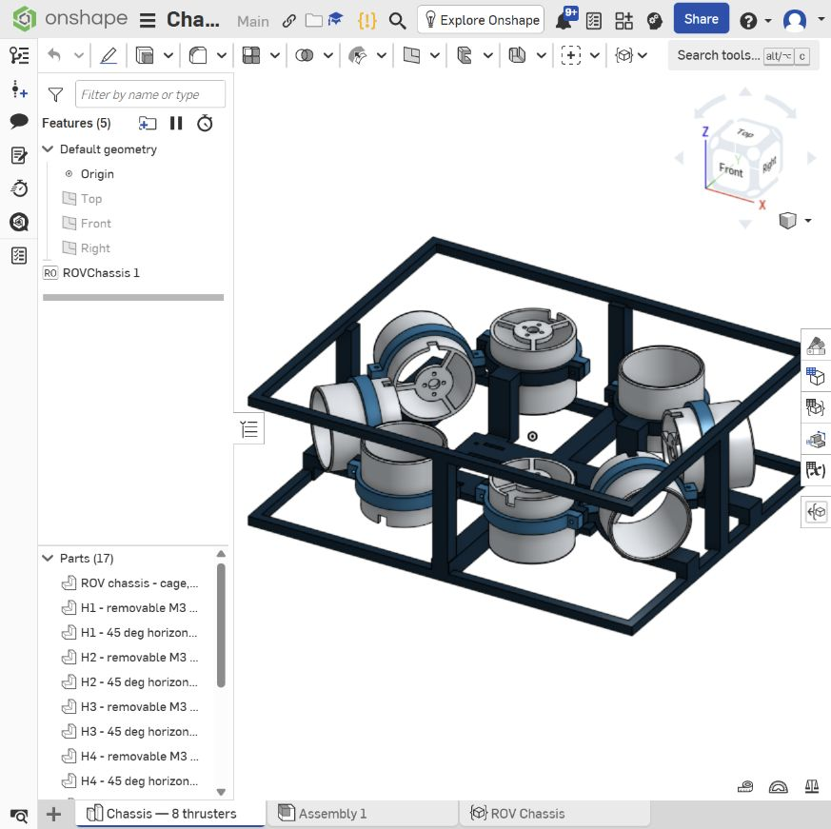
rov_chassis_onshape.jpg
