MatthewMa11/WebbSubmarineROV/rov_chassis_reinforced_onshape.jpg

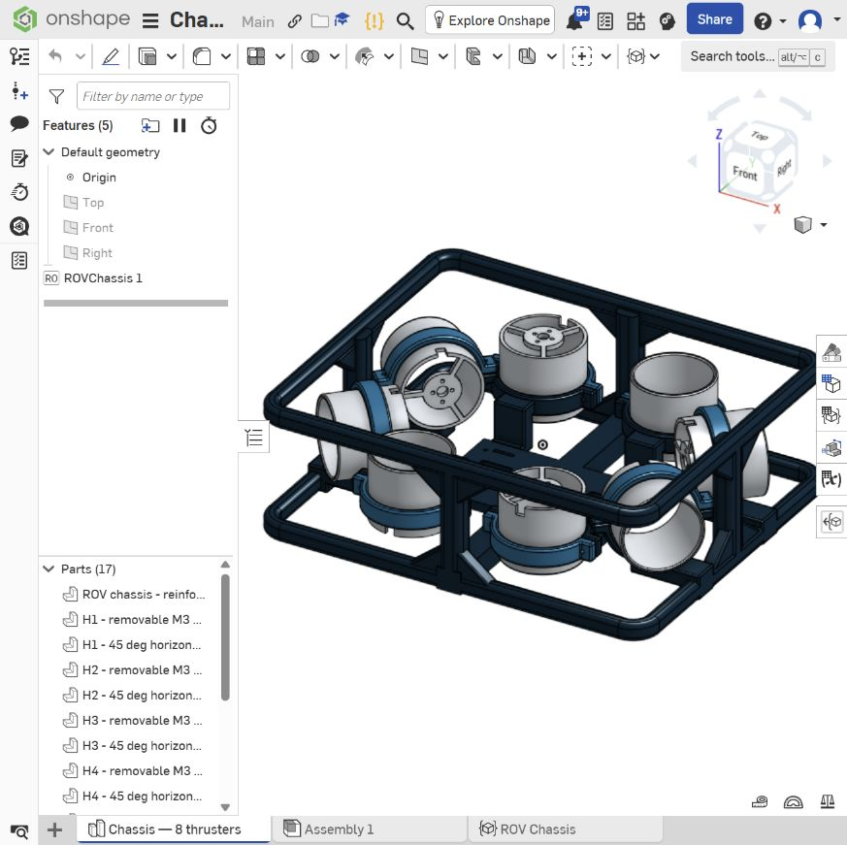
rov_chassis_reinforced_onshape.jpg
