MatthewMa11/WebbSubmarineROV/rov_holder_onshape.jpg

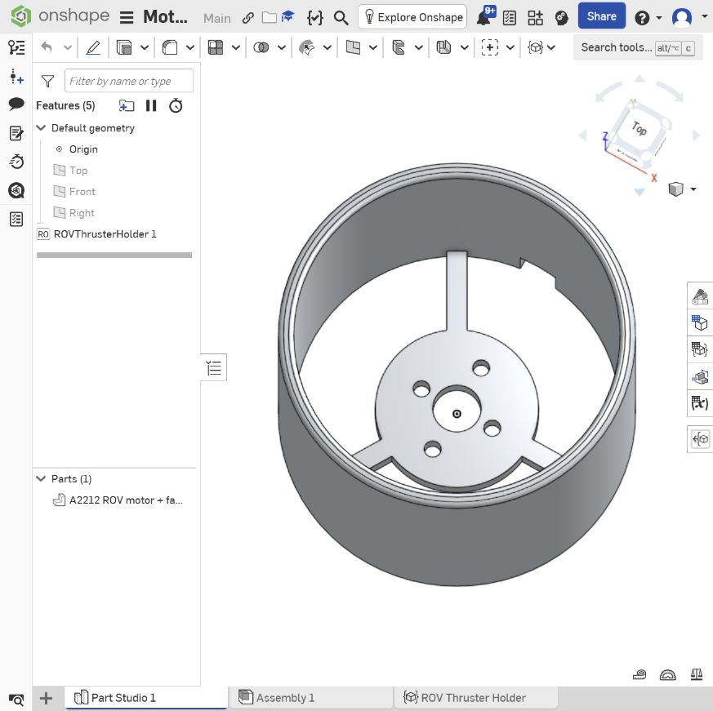
rov_holder_onshape.jpg
