MatthewMa11/WebbSubmarineROV/site-assets/rov-views/rov-top.png

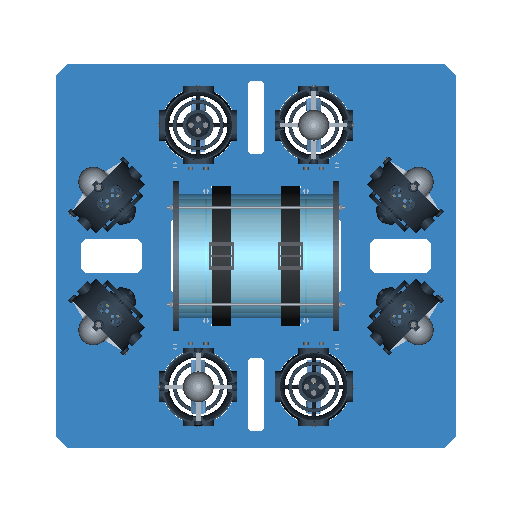
site-assets/rov-views/rov-top.png
