MatthewMa11/WebbSubmarineROV/site-assets/vision/frame-simplification.png

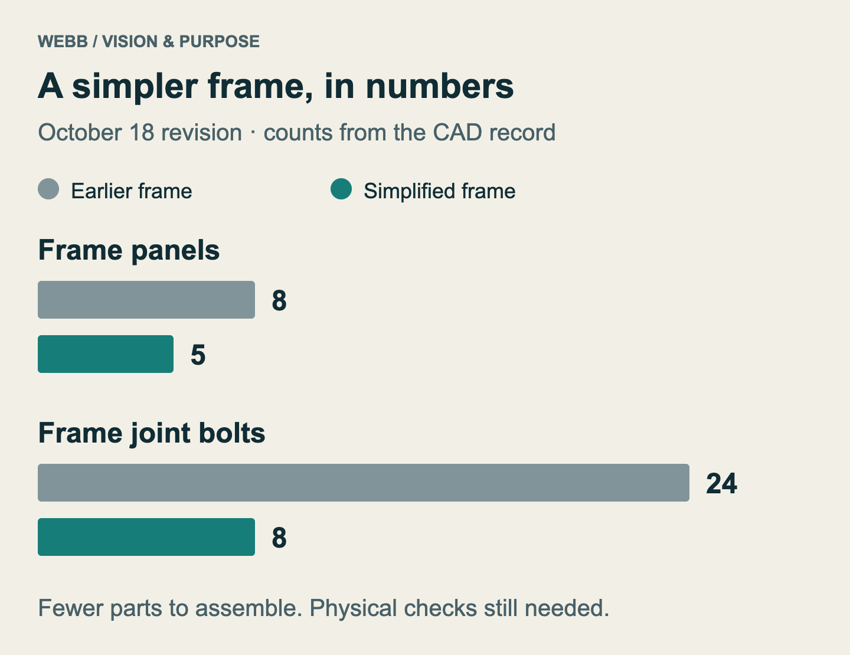
site-assets/vision/frame-simplification.png
