MatthewMa11/WebbSubmarineROV/site-assets/vision/museum-display-concept.png

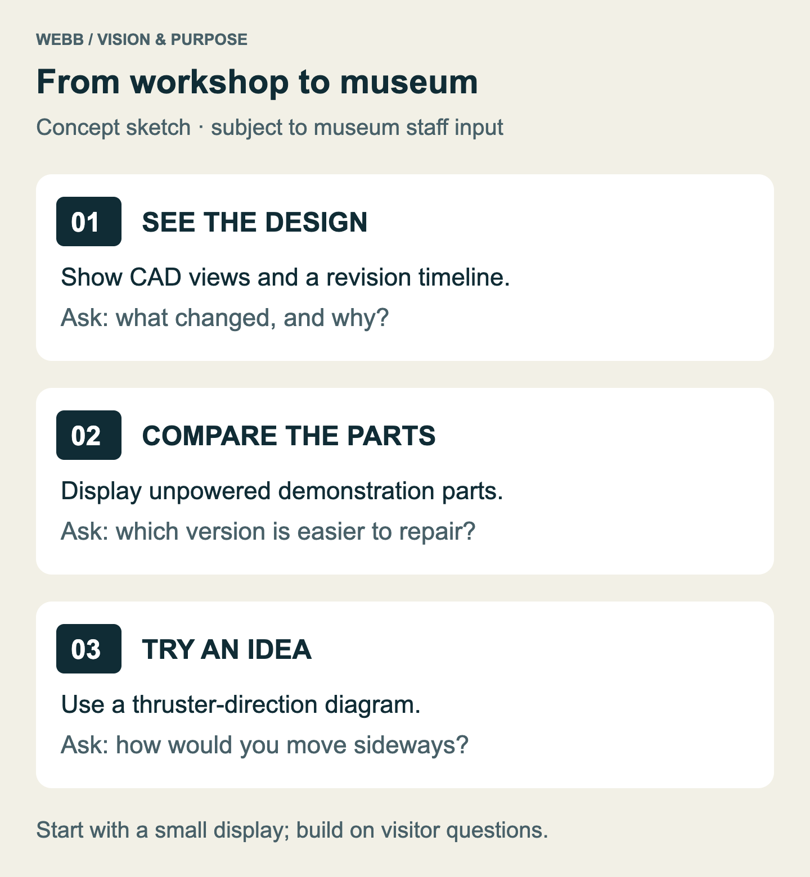
site-assets/vision/museum-display-concept.png
