MatthewMa11/WebbSubmarineROV/site-assets/vision/noaa-control-room.jpg

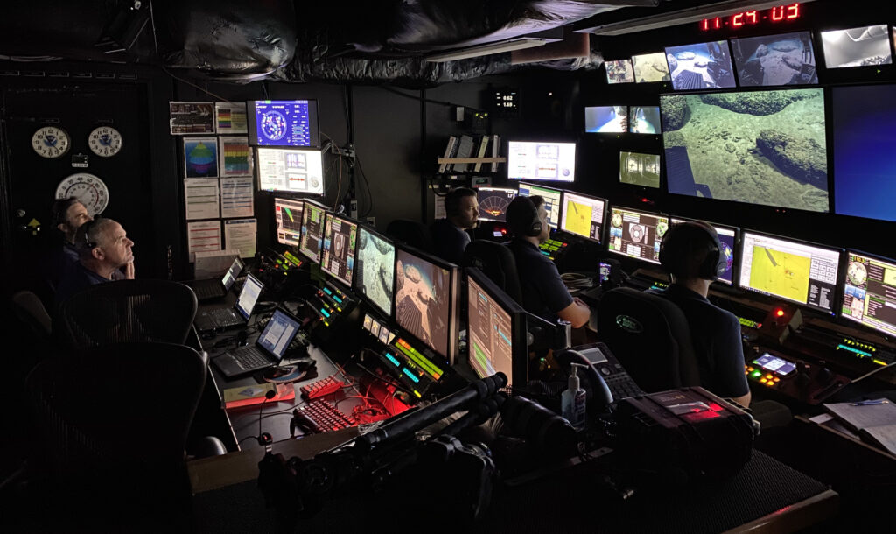
site-assets/vision/noaa-control-room.jpg
