MatthewMa11/WebbSubmarineROV/cad/easy-assembly-2026-10-18/cutting-and-hardware-list.csv

Item | Quantity | Specification | Notes
A base | 1 | 3 mm aluminum; 520 x 500 mm | A-base-QTY1.dxf
B side plate | 2 | 3 mm aluminum; about 240 x 84 mm | Identical pair; B-side-plate-QTY2.dxf
C open saddle | 2 | 3 mm aluminum; about 190 x 79 mm | Identical pair; C-open-saddle-QTY2.dxf
Frame bolt | 8 | M4x16 socket head | Replaces the 24 M3 frame-joint bolts
Frame washer | 8 | M4; 9 OD x 4.3 ID x 0.8 thick mm | Under bolt heads
Frame hex nut | 8 | M4; AF7 x 3.2 thick mm | Accessible cross pockets
Release strap | 2 | 25 mm adjustable webbing; side-release buckle | Purchased layout reference; select suitable retention rating
Complete electronics pod | 1 | Existing 160 OD x 148 ID x 200 mm tube, two caps, four tie rods | Retained; not pressure-qualified
Complete A2212 thruster | 8 | Existing 39-body R3 subassemblies | Positions and internals retained
