MatthewMa11/WebbSubmarineROV/cad/easy-assembly-2026-10-18/laser-cut-DXF/E04-open-saddle-identical.dxf

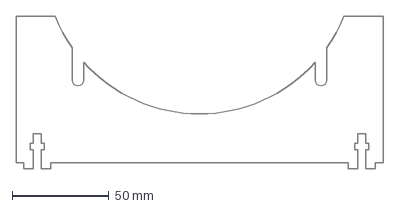
[picture p17: CAD file, 2026-10-26]
cad/easy-assembly-2026-10-18/laser-cut-DXF/E04-open-saddle-identical.dxf
190.0 x 78.8 mm
