MatthewMa11/WebbSubmarineROV/cad/laser-frame-electronics-2026-10-17/laser-cut-DXF/LC03-pod-bulkhead.dxf

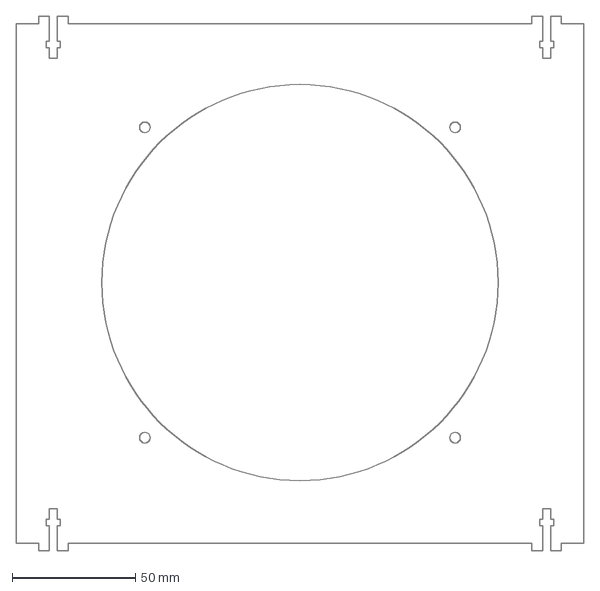
[picture p18: CAD file, 2026-10-26]
cad/laser-frame-electronics-2026-10-17/laser-cut-DXF/LC03-pod-bulkhead.dxf
230.0 x 216.8 mm
