MatthewMa11/WebbSubmarineROV/cad/easy-assembly-2026-10-18/laser-cut-DXF/E01-base-plate.dxf

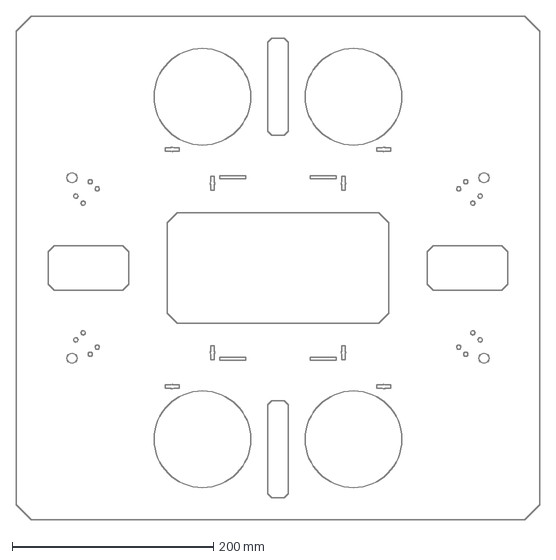
[picture p19: CAD file, 2026-10-26]
cad/easy-assembly-2026-10-18/laser-cut-DXF/E01-base-plate.dxf
520.0 x 500.0 mm
