MatthewMa11/WebbSubmarineROV/cad/laser-frame-electronics-2026-10-17/laser-cut-DXF/LC01-lower-deck.dxf

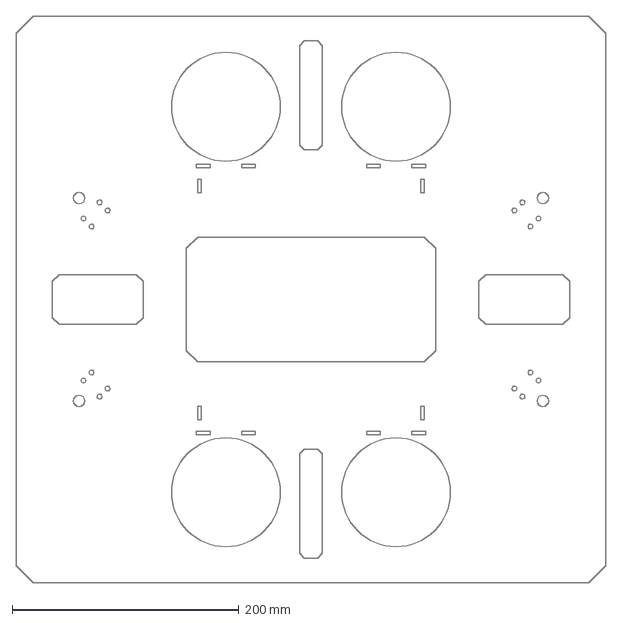
[picture p20: CAD file, 2026-10-26]
cad/laser-frame-electronics-2026-10-17/laser-cut-DXF/LC01-lower-deck.dxf
520.0 x 500.0 mm
