MatthewMa11/WebbSubmarineROV/cad/easy-assembly-2026-10-18/laser-cut-DXF/E03-side-rail-identical.dxf

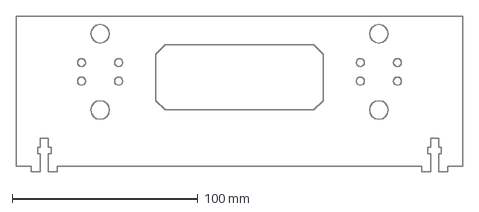
[picture p21: CAD file, 2026-10-26]
cad/easy-assembly-2026-10-18/laser-cut-DXF/E03-side-rail-identical.dxf
240.0 x 83.8 mm
