MatthewMa11/WebbSubmarineROV/cad/laser-frame-electronics-2026-10-17/laser-cut-DXF/LC06-vertical-thruster-support.dxf

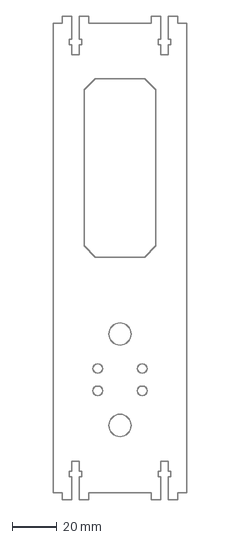
[picture p22: CAD file, 2026-10-26]
cad/laser-frame-electronics-2026-10-17/laser-cut-DXF/LC06-vertical-thruster-support.dxf
60.0 x 216.8 mm
