MatthewMa11/WebbSubmarineROV/cad/actual-onshape-motor-r11-2026-10-25/R11-complete-assembly.png

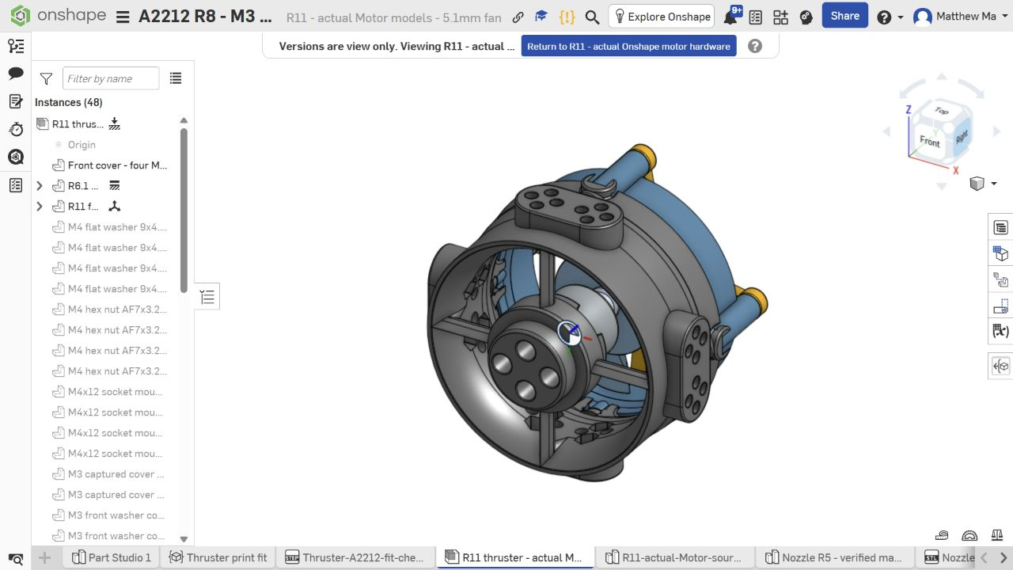
cad/actual-onshape-motor-r11-2026-10-25/R11-complete-assembly.png
