MatthewMa11/WebbSubmarineROV/cad/easy-assembly-2026-10-18/laser-cut-profile-preview.png

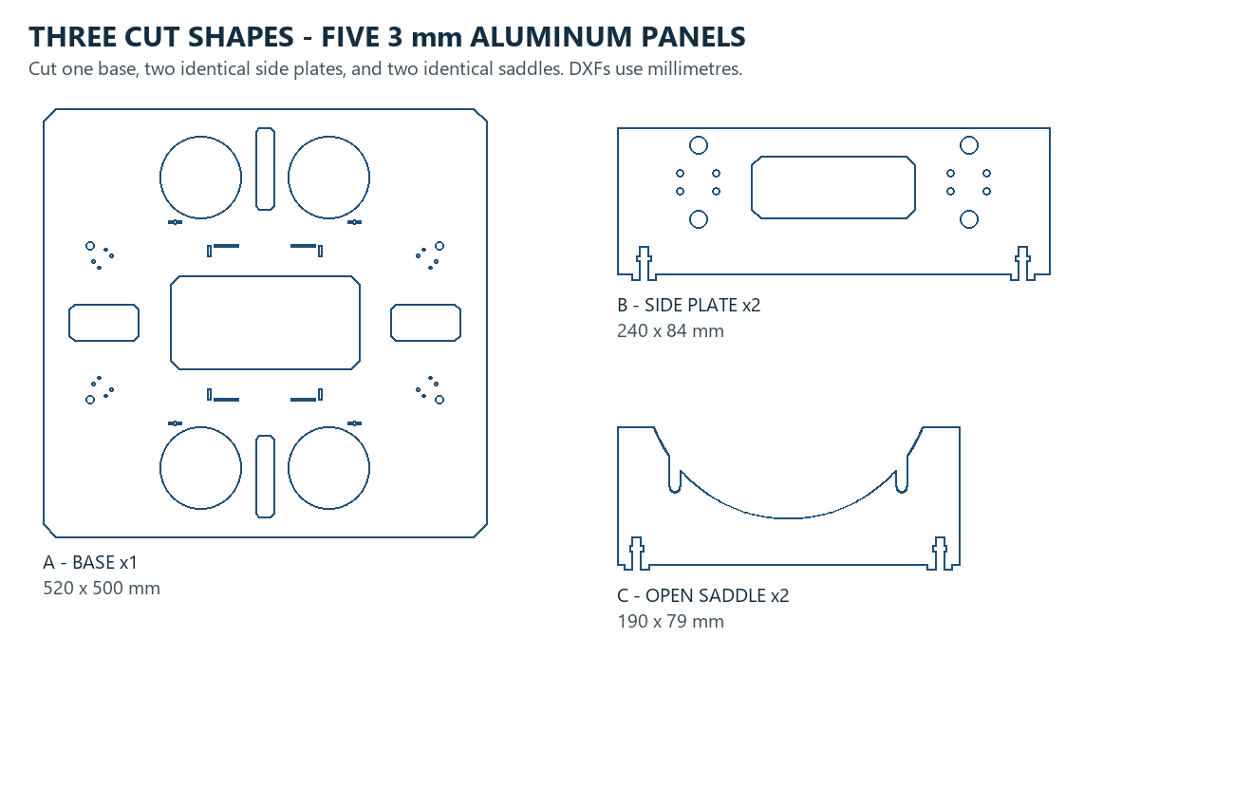
cad/easy-assembly-2026-10-18/laser-cut-profile-preview.png
