MatthewMa11/WebbSubmarineROV/cad/easy-assembly-2026-10-18/onshape-easy-assembly.png

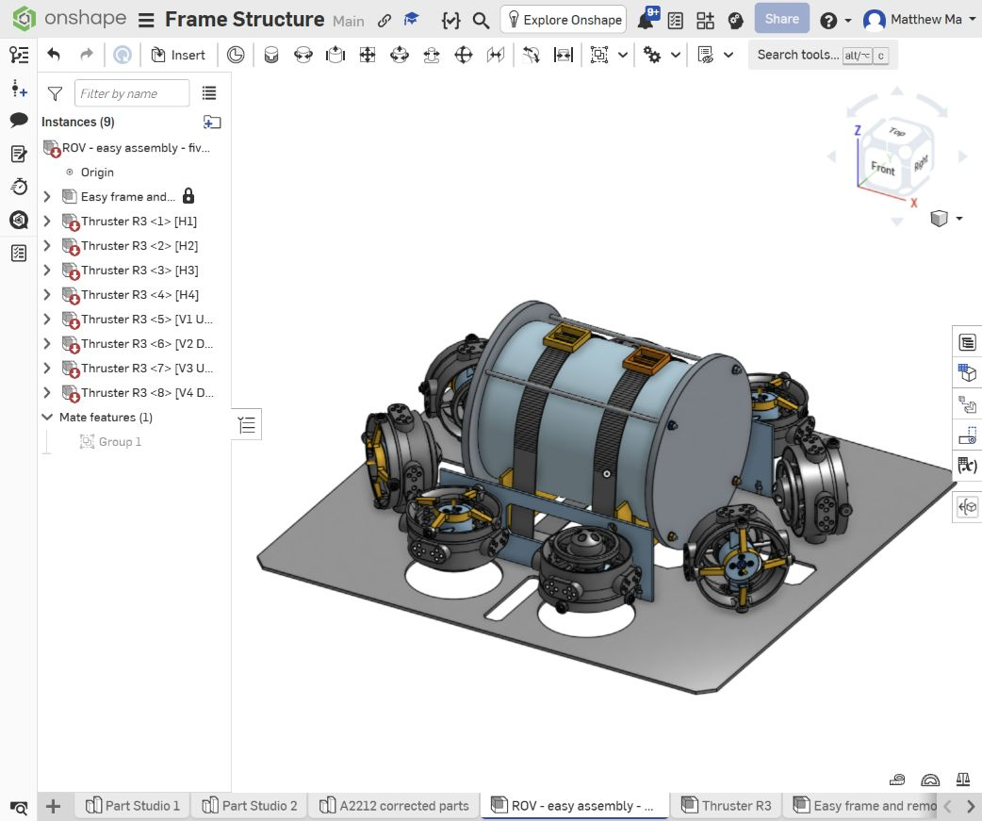
cad/easy-assembly-2026-10-18/onshape-easy-assembly.png
