MatthewMa11/WebbSubmarineROV/cad/eight-thruster-assembly-2026-10-17/onshape-eight-thrusters.png

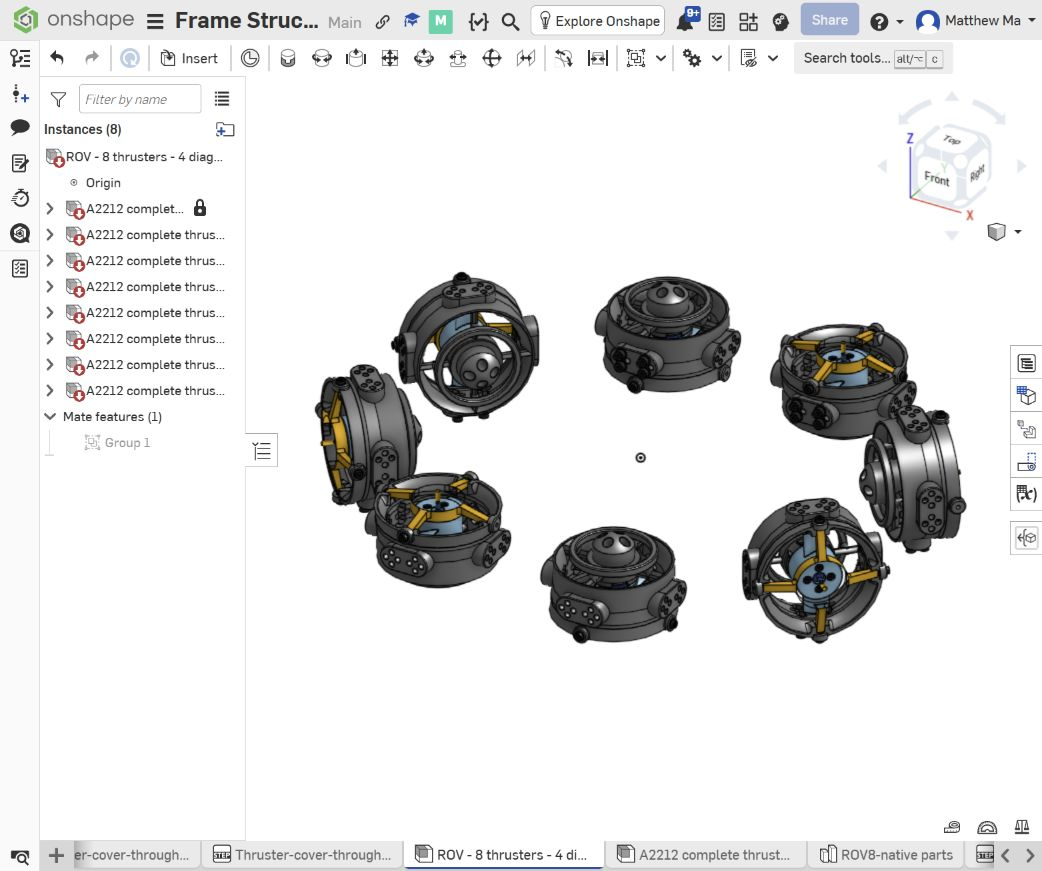
cad/eight-thruster-assembly-2026-10-17/onshape-eight-thrusters.png
