MatthewMa11/WebbSubmarineROV/rov_chassis_reinforced_kernel_result.txt

Feature 'reinforcedChassisSuite' evaluated successfully. Result:
{"btType": "BTFeatureScriptEvalResponse-1859", "rejectMicroversionSkew": false, "microversionSkew": false, "result": {"btType": "com.belmonttech.serialize.fsvalue.BTFSValueUndefined", "typeTag": ""}, "notices": [], "libraryVersion": 3083, "serializationVersion": "1.2.21", "sourceMicroversion": "48db113e5bf27e0b9e0134b2", "console": "{ default : { boundsMM : [ (-180, -150, -60) , (180, 150, 60) ] , checksPassed : 259 , solids : 17 } , hideReferenceMode : passed , propellerVariants : [ { boundsMM : [ (-210, -170, -70) , (210, 170, 70) ] , checksPassed : 259 , solids : 17 } , { boundsMM : [ (-220, -180, -70) , (220, 180, 70) ] , checksPassed : 259 , solids : 17 } ] , resized : { boundsMM : [ (-210, -170, -70) , (210, 170, 70) ] , checksPassed : 259 , solids : 17 } , trayMargin : passed }\nReinforcement and rounded profile checks passed.\nClamp clearance endpoints passed.\nAll reinforced chassis verification suites passed.\n"}
