MatthewMa11/WebbSubmarineROV/docs/journals/README.md

# Club journals

[Visit the Webb Submarine ROV home page](https://matthewma11.github.io/WebbSubmarineROV/) to read the journals on the club website and explore the project.

- [Motor & fan CAD journal](motor-and-fan-cad-development.md) — the illustrated history of the thruster, including its design changes, assembly decisions and remaining physical checks.
- [Club & museum vision journal](club-mission-and-museum-vision.md) — our mission to help the museum find underwater fossils with planned lights, cameras, and a robotic arm.
