MatthewMa11/WebbSubmarineROV/journals/motor-and-fan-cad-development.html

Skip to journal

WEBB SUBMARINE ROV Menu +

← Back to club home

ENGINEERING JOURNAL / 25 MIN READ

# Motor and fan CAD development journal

The motor and fan development story, from the PLA baseline through R14. Every revision includes supporting images and explanations.

BROWSE JOURNALS

On this page

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

## How to read the illustrations#

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

## Revision map#

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

## 15 October — establish the PLA baseline#

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

Sources: baseline instructions (https://github.com/MatthewMa11/WebbSubmarineROV/blob/main/cad/thruster-final-optimization/START-HERE-P1S-PLA.txt), verification scope (https://github.com/MatthewMa11/WebbSubmarineROV/blob/main/cad/thruster-final-optimization/CAD-verification-notes.txt), physical fit record (https://github.com/MatthewMa11/WebbSubmarineROV/blob/main/cad/thruster-final-optimization/physical-fit-record.csv).

## 17 October — R2 responds to the printed parts#

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

Sources: R2 instructions (https://github.com/MatthewMa11/WebbSubmarineROV/blob/main/cad/print-revision-2026-10-17/READ-ME-BEFORE-PRINTING.txt), physical test status (https://github.com/MatthewMa11/WebbSubmarineROV/blob/main/cad/print-revision-2026-10-17/physical-test-status.csv).

## 17 October — R3 guides the stationary motor base#

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

Source: R3 centering-cup instructions (https://github.com/MatthewMa11/WebbSubmarineROV/blob/main/cad/motor-centering-cover-2026-10-17/READ-ME-CENTERING-CUP.txt).

## 17 October — R4 makes the cover a through-bolted joint#

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

R4 cover joint stack. Schematic · not to scale · screw head to tip. M3x12 screw head → Front flat washer: 0.5 mm; Front flat washer: 0.5 mm → Cover tab: 5 mm; Cover tab: 5 mm → Nozzle seat: 3 mm; No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

Explanatory schematic · Open diagram to view full size

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

Source: R4 through-bolt instructions (https://github.com/MatthewMa11/WebbSubmarineROV/blob/main/cad/cover-through-bolts-2026-10-17/READ-ME-THROUGH-BOLTS.txt).

## 21 October — R5 removes the rear wire holder#

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

Source: R5 removal record (https://github.com/MatthewMa11/WebbSubmarineROV/blob/main/cad/remove-wire-holder-2026-10-21/READ-ME-R5.txt).

## 23 October — R6 removes the internal spacer#

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

R6 torque and axial retention. Intended functions · not measured load capacity. Motor-face openings → Four solid fan keys; Four solid fan keys → Transmit torque to the fan; Two opposed M3x16 bolt st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

Explanatory schematic · Open diagram to view full size · Scroll sideways on smaller screens

Sources: R6 assembly and fit limits (https://github.com/MatthewMa11/WebbSubmarineROV/blob/main/cad/spacer-free-design-2026-10-23/READ-ME-R6.txt), R6 status (https://github.com/MatthewMa11/WebbSubmarineROV/blob/main/cad/spacer-free-design-2026-10-23/design-status.json).

## 24 October — R6.1 flattens the rear boss#

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

Source: R6.1 rear-boss change (https://github.com/MatthewMa11/WebbSubmarineROV/blob/main/cad/flatter-motor-boss-2026-10-24/READ-ME-R6p1.txt).

## 24–25 October — R7 explores bolt-free external retention#

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

Sources: R7 engineering decisions (https://github.com/MatthewMa11/WebbSubmarineROV/blob/main/cad/bolt-free-retention-2026-10-24/ENGINEERING-NOTES.txt), R7 print/assembly instructions (https://github.com/MatthewMa11/WebbSubmarineROV/blob/main/cad/bolt-free-retention-2026-10-24/print/READ-ME.txt).

## 25 October — R8 moves retention to the axle#

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

Sources: R8 dimensions and assembly (https://github.com/MatthewMa11/WebbSubmarineROV/blob/main/cad/shaft-clamp-r8-2026-10-25/ASSEMBLY-AND-PRINT.txt), R8 tool-access correction (https://github.com/MatthewMa11/WebbSubmarineROV/blob/main/cad/shaft-clamp-r8-2026-10-25/FINAL-REVIEW.txt).

## 25 October — R9 reorganizes the fan around the sketch layout#

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

Sources: R9 layout (https://github.com/MatthewMa11/WebbSubmarineROV/blob/main/cad/sketch-layout-r9-2026-10-25/ASSEMBLY-AND-PRINT.txt), R9 review and insertion correction (https://github.com/MatthewMa11/WebbSubmarineROV/blob/main/cad/sketch-layout-r9-2026-10-25/FINAL-REVIEW.txt).

## 25 October — R10 changes to a metal collet adapter#

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

Sources: R10 design (https://github.com/MatthewMa11/WebbSubmarineROV/blob/main/cad/metal-collet-r10-2026-10-25/DESIGN.txt), R10 assembly (https://github.com/MatthewMa11/WebbSubmarineROV/blob/main/cad/metal-collet-r10-2026-10-25/ASSEMBLY-AND-PRINT.txt), R10 final review (https://github.com/MatthewMa11/WebbSubmarineROV/blob/main/cad/metal-collet-r10-2026-10-25/FINAL-REVIEW.txt).

## 25 October — R11 matches the actual Onshape motor and adapter#

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

Sources: R11 design and measured interfaces (https://github.com/MatthewMa11/WebbSubmarineROV/blob/main/cad/actual-onshape-motor-r11-2026-10-25/DESIGN.txt), R11 instructions (https://github.com/MatthewMa11/WebbSubmarineROV/blob/main/cad/actual-onshape-motor-r11-2026-10-25/ASSEMBLY-AND-PRINT.txt), R11 provenance and corrections (https://github.com/MatthewMa11/WebbSubmarineROV/blob/main/cad/actual-onshape-motor-r11-2026-10-25/progress.md).

## 25 October — R12 combines the frame and duct#

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

Sources: R12 design (https://github.com/MatthewMa11/WebbSubmarineROV/blob/main/cad/one-piece-housing-r12-2026-10-25/DESIGN.txt), R12 assembly and print guide (https://github.com/MatthewMa11/WebbSubmarineROV/blob/main/cad/one-piece-housing-r12-2026-10-25/ASSEMBLY-AND-PRINT.txt), R12 review (https://github.com/MatthewMa11/WebbSubmarineROV/blob/main/cad/one-piece-housing-r12-2026-10-25/FINAL-REVIEW.txt).

## 25 October — R13 creates the concave cone and accessible short-bolt joints#

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

Sources: R13 design (https://github.com/MatthewMa11/WebbSubmarineROV/blob/main/cad/concave-cap-r13-2026-10-25/DESIGN.txt), R13 matched-part instructions (https://github.com/MatthewMa11/WebbSubmarineROV/blob/main/cad/concave-cap-r13-2026-10-25/ASSEMBLY-AND-PRINT.txt), R13 review limits (https://github.com/MatthewMa11/WebbSubmarineROV/blob/main/cad/concave-cap-r13-2026-10-25/FINAL-REVIEW.txt).

## 25 October — R14 removes obsolete mounts and smooths the housing#

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

Sources: R14 design (https://github.com/MatthewMa11/WebbSubmarineROV/blob/main/cad/smooth-frame-r14-2026-10-25/DESIGN.txt), R14 assembly guide (https://github.com/MatthewMa11/WebbSubmarineROV/blob/main/cad/smooth-frame-r14-2026-10-25/ASSEMBLY-AND-PRINT.txt), R14 final review (https://github.com/MatthewMa11/WebbSubmarineROV/blob/main/cad/smooth-frame-r14-2026-10-25/FINAL-REVIEW.txt), print verification (https://github.com/MatthewMa11/WebbSubmarineROV/blob/main/cad/smooth-frame-r14-2026-10-25/print-verification.json).

## Current print starting point and remaining evidence#

For a new print matching the latest recorded design, start with the R14 print kit and its assembly instructions (https://github.com/MatthewMa11/WebbSubmarineROV/blob/main/cad/smooth-frame-r14-2026-10-25/ASSEMBLY-AND-PRINT.txt). The intended combination is R14 housing + R13 cone + R11 fan + the matching actual metal motor/adapter. The internal motor insert and all earlier printed fan clamps are absent. A usable R11 fan and R13 cone can be reused; only the housing changed for R14.

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

Current saved thruster assembly. Arrows mean inclusion · not force or torque paths. R14 smooth housing → Current saved thruster assembly; R13 concave cone → Current saved thruster assembly; R11 fan 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

Explanatory schematic · Open diagram to view full size · Scroll sideways on smaller screens

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

The saved package report (https://github.com/MatthewMa11/WebbSubmarineROV/blob/main/cad/smooth-frame-r14-2026-10-25/package-verification.json) records 24 ZIP entries, a valid CRC and source-byte agreement. That supports package provenance. It does not prove a print will fit the actual motor, that a hub will remain clamped after heating or reversal, or that the fan is balanced.

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

KEEP READING

Club & museum vision journal →← Return to club home

WEBB
SUBMARINE ROV

Club home ↗

View journal source on GitHub (https://github.com/MatthewMa11/WebbSubmarineROV/blob/main/docs/journals/motor-and-fan-cad-development.md)PROJECT RECORD · OCTOBER 26, 2026Back to top ↑

ⅡPause scene
