MatthewMa11/WebbSubmarineROV/journals/overall-project-journal.html

Skip to journal

WEBB SUBMARINE ROV Menu +

← All project journals

OVERALL PROJECT RECORD / DEVELOPMENT LOG

# The work. The setbacks. The next revision.

From the first subsystem designs to the motor’s first spin. The club’s complete written journal, with the decisions, measurements, photos, and experiments behind the ROV.

PROJECT RECORDS

On this page

From the club’s nine-page journal. The full written record is presented below as webpage text, with the original photos and connection diagram. Dates and experimental results are retained from the source; line breaks and minor typing errors have been cleaned up.
Download original PDF ↓View source on GitHub ↗ (https://github.com/MatthewMa11/WebbSubmarineROV/blob/main/downloads/rov-journal.pdf)

01 / EARLIER DEVELOPMENT

## DECEMBER 2023–MAY 2025Past documentation summary

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

## Methodology

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

## Key progress

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

## Past challenges and design responses

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

## MAY 2025Status at the end of the record

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

02 / THE CAD & HARDWARE JOURNAL

## OCTOBER 15–26Webb Submarine ROV journal

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

## OCTOBER 15Establishing a print baseline

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

## OCTOBER 17Blade rub and a tight insert

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

## OCTOBER 17–18Making the frame easier to service

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

## OCTOBER 21–24Removing parts and revisiting retention

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

## OCTOBER 24–25Finding a better way to mount the fan

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

## OCTOBER 25Combining the duct and refining the housing

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

Printed thruster, rear view. Original journal photo, page 6.

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

Printed thruster, front view. Original journal photo, page 6.

03 / ELECTRONICS & MOTOR TESTS

## OCTOBER 29Raspberry Pi and computer communication

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

## OCTOBER 30Connecting the Pi, PCA9685, ESC, and motor

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

Raspberry Pi 4 on a separate USB-C supply connects by I2C, 3.3 volts and ground to the PCA9685. Its channel 0 PWM and signal ground connect to the brushless ESC. A separate motor battery also connec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

Actual motor-control connection photographed by the club. Original journal photo, page 8.

## OCTOBER 31–NOVEMBER 7Coding and getting the motor to spin

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

The source has a “Code” heading but contains no code listing.

KEEP EXPLORING

Explore the detailed motor & fan CAD journal →Open the parts list & movement budget →

WEBB
SUBMARINE ROV

Explore the repository ↗ (https://github.com/MatthewMa11/WebbSubmarineROV)

Learning through underwater engineering.PROJECT RECORD · OCTOBER 26, 2026Back to the surface ↑

ⅡPause scene
