MatthewMa11/WebbSubmarineROV/(commit log)

2026-10-26 Import ROV design sources, verification records, and development journals
    [A-base-QTY1.dxf, B-side-plate-QTY2.dxf, C-open-saddle-QTY2.dxf, E01-base-plate.dxf, E02-side-rail-identical.dxf, E03-side-rail-identical.dxf, E04-open-saddle-identical.dxf, E05-open-saddle-identical.dxf]
2026-10-26 Add CAD development illustrations and clarify archive access
2026-10-26 Add current R14 print kit
2026-10-26 Preserve CAD revision archives 1 of 15
2026-10-26 Preserve CAD revision archives 2 of 15
2026-10-26 Link complete CAD archives to the development release
2026-10-26 Add public club website with CAD journals and design downloads
2026-10-26 Illustrate every thruster revision with source images and engineering diagrams
2026-10-27 Illustrate club vision journal with ROV photos, CAD views and design graphics
2026-10-27 Replace frame chart with real ROV example photos
2026-11-12 Publish overall ROV journal and movement-module buying list
    Add the original PDF and Excel workbook, a dated Google Sheets snapshot, and website readers for the journal and both movement budgets. Link the records from the homepage, downloads, and repository README.
    [rov-movement-module-8-motors.xlsx]
2026-11-13 Add an interactive Ocean Lab with marine discovery and ROV training
    Create a sourced depth explorer with illustrated creature encounters, a fictional sonar and fossil-documentation mission, and a touch-friendly light-painting canvas. Link the activities throughout the site and add a homepage whale ripple interaction. Preserve native journals and downloads; include model tests and motion controls.
2026-11-13 Keep touch steering and documentation controls on the training map
    Move steering onto the map and add a compact phone document action. Add quiet jelly silhouettes to the light-painting canvas and version the updated assets to avoid stale browser controls.
2026-11-13 Restore the earlier site and replace animals with the actual ROV
    Keep the fossil-search mission and refocus the depth view on real vehicle CAD with isometric, top, and side cameras. Replace the homepage whale and the training marker with renders of the existing assembly. Restore the previous page structure and remove creature encounters, glow painting, ripple controls, and the Ocean Lab gateway.
2026-11-13 Restore the whale site exactly and confine changes to the search game
    Restore every original site file byte-for-byte from the pre-Ocean-Lab version. Keep only the standalone search mission and its required assets, using the actual ROV top-view CAD as the game vehicle. Remove the depth explorer and all non-game additions.
2026-11-13 Add the ROV game link to the navigation bar
    Insert only the ROV game anchor in each public page's existing navigation. Preserve all other markup, content, styling, assets, and game behavior.
